Harry-Chen/fpga-virtual-console/doc/report/report.tex

 % !TEX root = report.tex
 % !TEX program = xelatex
 
\documentclass[fontset=fandol]{ctexart}

\usepackage{graphicx}
\usepackage{lscape}
\usepackage{geometry}
\usepackage{hyperref}
\usepackage{hyperxmp}
\usepackage{pdfpages}
\usepackage{longtable}
\usepackage{booktabs}
\usepackage[bottom]{footmisc}
\usepackage{amsmath}
\usepackage{bytefield}
\usepackage{url}

\newcommand{\artauthor}{陈晟祺；周聿浩}
\newcommand{\arttitle}{FPGA Console 设计报告}
\newcommand{\artsubject}{硬件实现的 VT220 兼容终端}
\newcommand{\artkeywords}{FPGA；终端；Console}

\hypersetup{pdfauthor=\artauthor,
			pdftitle=\arttitle,
			pdfsubject=\artsubject,
			pdfkeywords=\artkeywords,
			pdfcopyright={Copyright Shengqi Chen & Yuhao zhou 2018. All rights reserved.},
			pdfdate=\today,
			pdfdisplaydoctitle=true,
			pdflang=zh-CN,
			pdfstartview=FitH}

\geometry{
	a4paper,
	left=3.18cm,
	right=3.18cm,
	top=2.54cm,
	bottom=2.54cm
}
\graphicspath{{figures/}}

\begin{document}

\title{{\bf\arttitle\\——\artsubject}}
\author{
计63\hspace{1em}陈晟祺\hspace{1em}2016010981 \\
计64\hspace{1em}周聿浩\hspace{1em}2016011347
}
\date{}
\maketitle

\tableofcontents

\section{项目概述}

\input{introduction}

\section{架构设计}

\input{architecture}

% implementation
\input{implementation}

\section{其他说明}

\input{misc}

\end{document}
