Harry-Chen/fpga-virtual-console/doc/report/misc.tex

 % !TEX root = report.tex
 % !TEX program = xelatex

 本项目是基于Cyclone IV EP4CE55F23I7开发的，具体的运行说明请见源码根目录下的\texttt{README.md}。

 感谢计研173张宇翔学长提供的项目灵感和实验板，他在我们的开发过程中帮助我们解答了各类疑难问题，也协助我们进行了一些调试工作。
 同时也感谢老师和助教的大力支持。缺少了诸位的帮助，写好这个项目是不可能的。
