Harry-Chen/fpga-virtual-console/demo/demo-commands.md

# Setup

For VT220 mode, run `./set_vt220.sh`.

For Xterm mode, run `./set_xterm.sh`.

# VT220 Mode

* `aafire`
* `aatest`
* `bb`
* `cowsay`
* `./bad_apple.sh`

# XTerm Mode

* `cacafire`
* `cacademo`
* `cacaview [images_path]`
* `screenfetch`
* `./asciicam.sh`
* `./video.sh [video_path]`
* `./emacs`, then input `ESC-x` and `tetris`.
* `cmatrix`
* `toilet`
* `ninvaders`: Ncurses based space invaders clone.
* `nsnake `: Customizable Snake game with ncurses for the terminal.
