Harry-Chen/fpga-virtual-console/doc/reference/websites.md

[Hardware implementation of an EAN-13 bar... (PDF Download Available)](https://www.researchgate.net/publication/4012338_Hardware_implementation_of_an_EAN-13_bar_code_decoder)

[Add a real life hardware terminal to that newfangled computer of yours | Hackaday](https://hackaday.com/2011/08/11/add-a-real-life-hardware-terminal-to-that-newfangled-computer-of-yours/)

[vt100 terminal emulator in a FPGA - how small can the FPGA be? - Google 网上论坛](https://groups.google.com/forum/#!topic/comp.terminals/9ydsHcoIR7k)

[FPGA Serial Terminal | Hackaday.io](https://hackaday.io/project/7165-fpga-serial-terminal)

[Video Terminals](http://www.sparetimegizmos.com/Hardware/VT.htm)

[Video Terminal Project](http://vt4.sourceforge.net/)

[vt100 | Hackaday](https://hackaday.com/tag/vt100/)

[howardjones/fpga-vt: VT100-style terminal implemented on FPGA in VHDL](https://github.com/howardjones/fpga-vt)

[bash:tip_colors_and_formatting - FLOZz' MISC](https://misc.flogisoft.com/bash/tip_colors_and_formatting)

[Video Display Terminal Information – VT100.net](https://vt100.net/)

[NCURSES — Frequently Asked Questions (FAQ)](http://invisible-island.net/ncurses/ncurses.faq.html#vt100_color)

[keyboard fpga combination - Google 搜索](https://www.google.com/search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)

[PS/2 Keyboard to ASCII Converter (VHDL) - Logic - eewiki](https://eewiki.net/pages/viewpage.action?pageId=28279002)

[FPGA Keyboard Interface – Embedded Thoughts](https://embeddedthoughts.com/2016/07/05/fpga-keyboard-interface/)

[PS2 Keyboard for FPGA](http://www.instructables.com/id/PS2-Keyboard-for-FPGA/)

[【小梅哥FPGA进阶教程】第六章 PS2键盘驱动设计与验证 - FPGA/CPLD - 电子工程世界-论坛](http://bbs.eeworld.com.cn/thread-513009-1-1.html)

[Digital VT100 User Guide: Programmer Information](https://vt100.net/docs/vt100-ug/chapter3.html)

[PS2-KeyBoard-FPGA/ps2-keyboard-16.png at master · Obijuan/PS2-KeyBoard-FPGA](https://github.com/Obijuan/PS2-KeyBoard-FPGA/blob/master/wiki/ps2-keyboard-16.png)

[PS/2 Keyboard Interface (VHDL) - Logic - eewiki](https://eewiki.net/pages/viewpage.action?pageId=28278929)

[~libvterm/libvterm/trunk : files for revision 718](https://bazaar.launchpad.net/~libvterm/libvterm/trunk/files/head:/src/)

[VT100 commands](http://braun-home.net/michael/info/misc/VT100_commands.htm)

[The TTY demystified](http://www.linusakesson.net/programming/tty/index.php)

[Console Virtual Terminal Sequences](https://docs.microsoft.com/en-us/windows/console/console-virtual-terminal-sequences)
