Harry-Chen/fpga-virtual-console/(list of files, cad)

Other CAD files:
src/debug/stp.stp
