Harry-Chen/fpga-virtual-console/doc/report/figures/command_parser.pdf

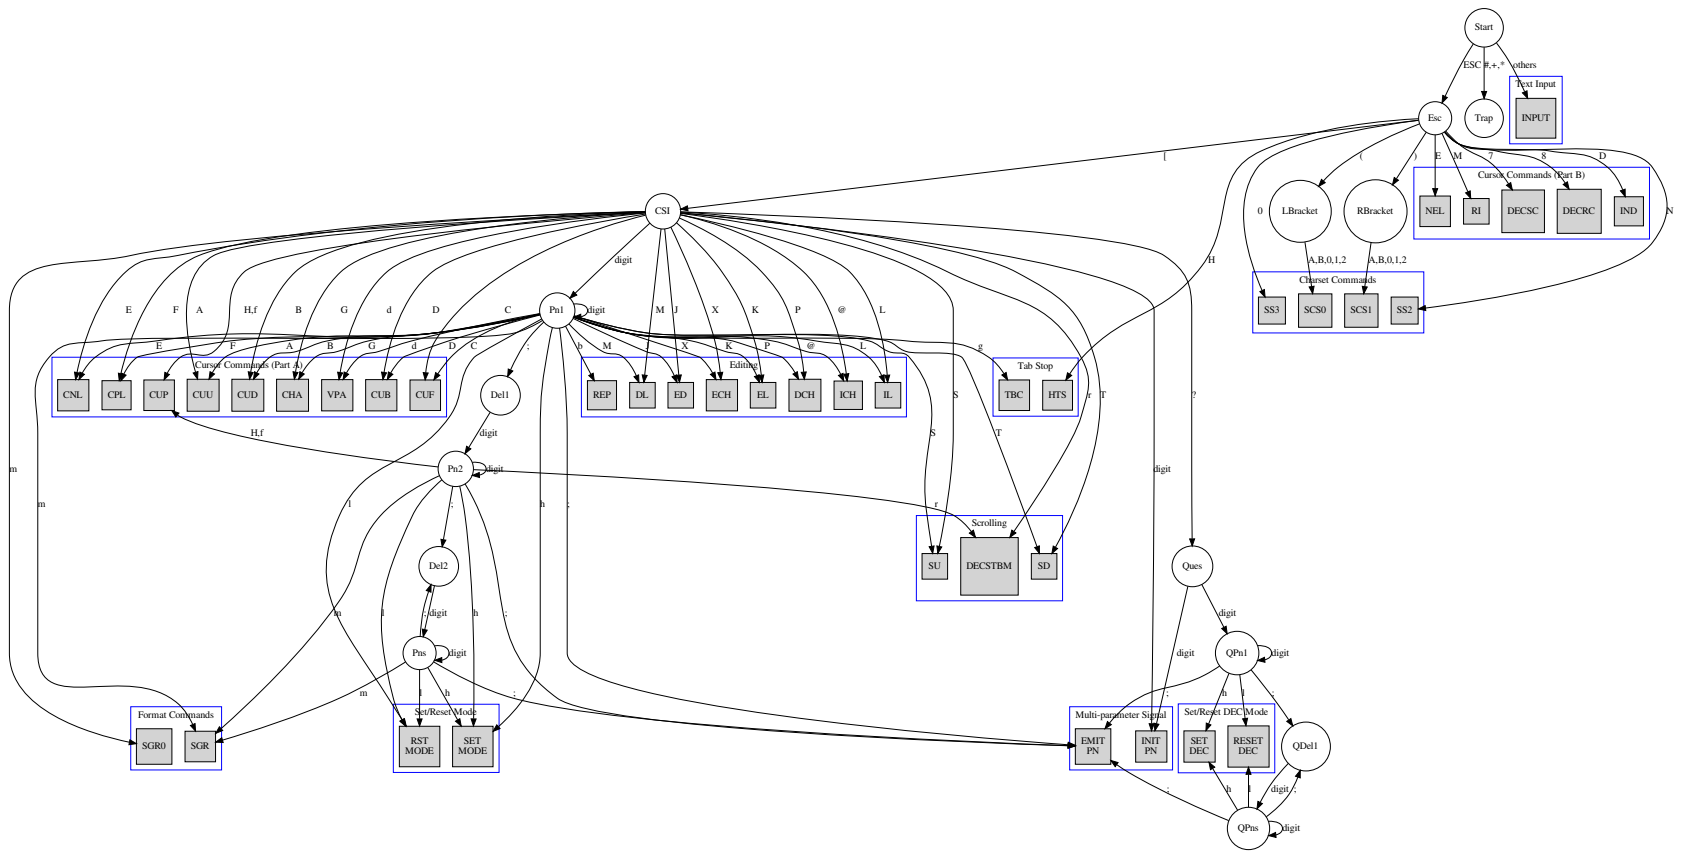
[picture p17: page 1]
Format Commands; Multi-parameter Signal; Charset Commands; Scrolling; Editing; Set/Reset Mode; Set/Reset DEC Mode; Text Input; Tab Stop; Start; Esc; ESC; Trap; INPUT; others; CSI; LBracket; RBracket; IND; NEL; DECSC; DECRC; HTS; digit; Ques; INIT PN; SGR0; CUU; CUD; CUF; CUB; CUP; CNL; CPL; CHA; VPA; DECSTBM; ECH; DCH; ICH; Del1; EMIT PN; SGR; REP; SET MODE; RST MODE; TBC; Del2; Pns; ; digit; SCS0; SCS1; QPn1; QDel1; SET DEC; RESET DEC; QPns; digit ;

Cursor Commands (Part B)

Cursor Commands (Part A)
