Harry-Chen/fpga-virtual-console/doc/report/figures/architecture_design_visio.pdf

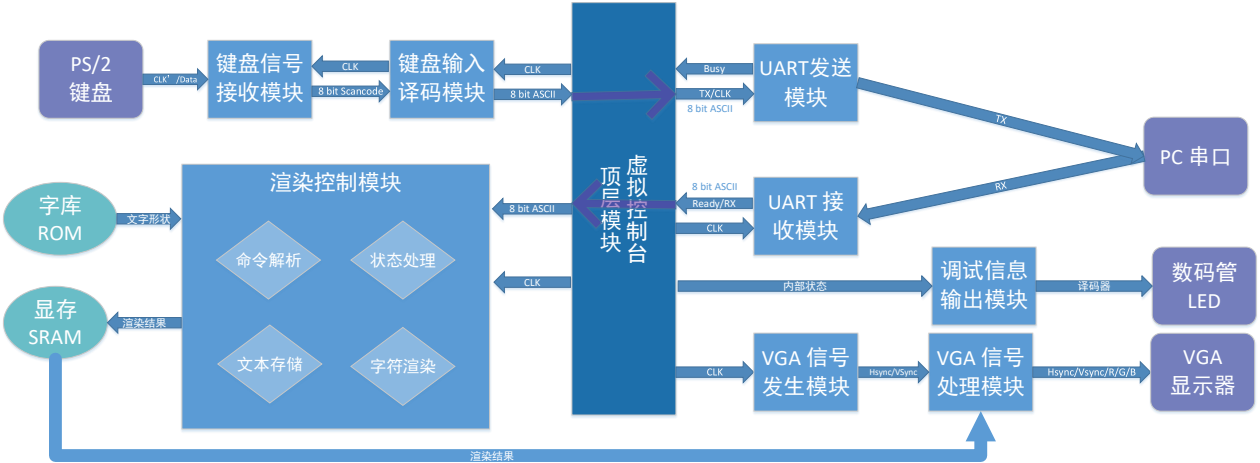
[picture p18: page 1]
键盘信号 接收模块; 键盘输入 译码模块; 虚拟控制台; 顶层模块; UART发送 模块; UART; 接 收模块; VGA 信号 处理模块; Busy; Ready; VGA 显示器; CLK CLK; Hsync; /VSync; VGA 信号 发生模块; 渲染控制模块; 8 bit ASCII; CLK; 字库 ROM; 文字形状; 显存 SRAM; 渲染结果; 命令解析; 状态处理; 文本存储; 字符渲染; 调试信息 输出模块; 数码管 LED; 内部状态; 译码器
