Harry-Chen/fpga-virtual-console/doc/report/figures/graphics_control.pdf

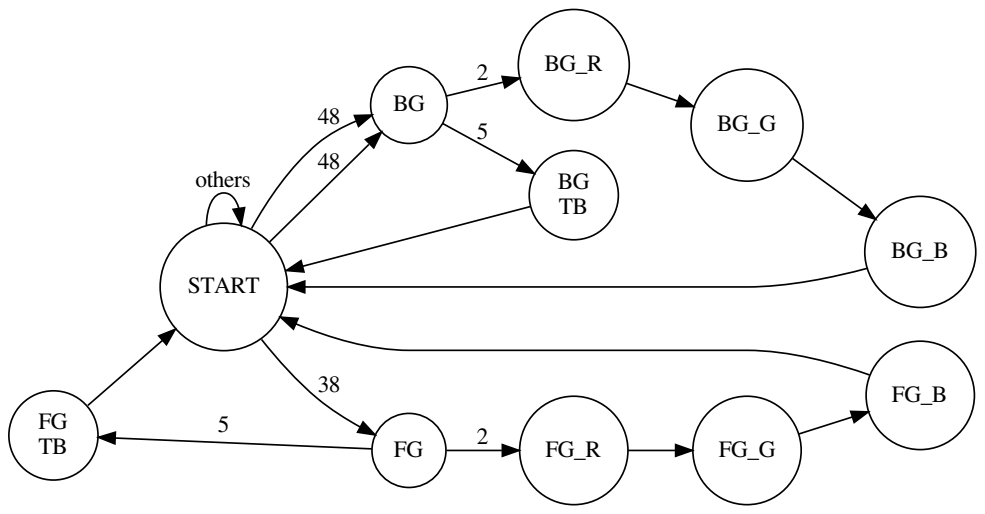
[picture p19: page 1]
START; others
