Harry-Chen/fpga-virtual-console/doc/report/figures/text_control.pdf

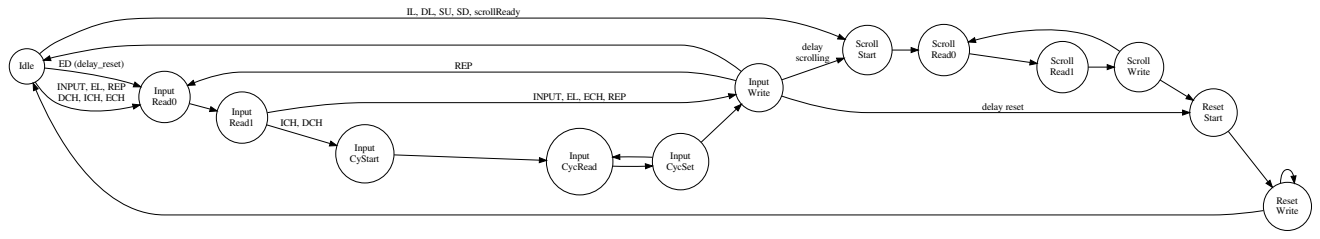
[picture p20: page 1]
Idle; Input Read0; ED (delay_reset); Scroll Start; Input Read1; Input CyStart; ICH, DCH; Input; Input CycRead; Input CycSet; REP; delay scrolling; Reset Start; delay reset; Scroll; Read0; Read1; Scroll Write; Reset Write

IL, DL, SU, SD, scrollReady

INPUT, EL, REP
DCH, ICH, ECH

Write INPUT, EL, ECH, REP
