Harry-Chen/fpga-virtual-console/testbench/TextRam.v

// synopsys translate_off
`timescale 1 ps / 1 ps
// synopsys translate_on
module TextRam (
	aclr_a,
	aclr_b,
	address_a,
	address_b,
	clock_a,
	clock_b,
	data_a,
	data_b,
	wren_a,
	wren_b,
	q_a,
	q_b);

	input	  aclr_a;
	input	  aclr_b;
	input	[5:0]  address_a;
	input	[5:0]  address_b;
	input	  clock_a;
	input	  clock_b;
	input	[1279:0]  data_a;
	input	[1279:0]  data_b;
	input	  wren_a;
	input	  wren_b;
	output	[1279:0]  q_a;
	output	[1279:0]  q_b;
`ifndef ALTERA_RESERVED_QIS
// synopsys translate_off
`endif
	tri0	  aclr_a;
	tri0	  aclr_b;
	tri1	  clock_a;
	tri0	  wren_a;
	tri0	  wren_b;
`ifndef ALTERA_RESERVED_QIS
// synopsys translate_on
`endif

	wire [1279:0] sub_wire0;
	wire [1279:0] sub_wire1;
	wire [1279:0] q_a = sub_wire0[1279:0];
	wire [1279:0] q_b = sub_wire1[1279:0];

	altsyncram	altsyncram_component (
				.aclr0 (aclr_a),
				.aclr1 (aclr_b),
				.address_a (address_a),
				.address_b (address_b),
				.clock0 (clock_a),
				.clock1 (clock_b),
				.data_a (data_a),
				.data_b (data_b),
				.wren_a (wren_a),
				.wren_b (wren_b),
				.q_a (sub_wire0),
				.q_b (sub_wire1),
				.addressstall_a (1'b0),
				.addressstall_b (1'b0),
				.byteena_a (1'b1),
				.byteena_b (1'b1),
				.clocken0 (1'b1),
				.clocken1 (1'b1),
				.clocken2 (1'b1),
				.clocken3 (1'b1),
				.eccstatus (),
				.rden_a (1'b1),
				.rden_b (1'b1));
	defparam
		altsyncram_component.address_reg_b = "CLOCK1",
		altsyncram_component.clock_enable_input_a = "BYPASS",
		altsyncram_component.clock_enable_input_b = "BYPASS",
		altsyncram_component.clock_enable_output_a = "BYPASS",
		altsyncram_component.clock_enable_output_b = "BYPASS",
		altsyncram_component.indata_reg_b = "CLOCK1",
		altsyncram_component.init_file = "TextRamDemo.hex",
		altsyncram_component.intended_device_family = "Cyclone IV E",
		altsyncram_component.lpm_type = "altsyncram",
		altsyncram_component.numwords_a = 40,
		altsyncram_component.numwords_b = 40,
		altsyncram_component.operation_mode = "BIDIR_DUAL_PORT",
		altsyncram_component.outdata_aclr_a = "CLEAR0",
		altsyncram_component.outdata_aclr_b = "CLEAR1",
		altsyncram_component.outdata_reg_a = "UNREGISTERED",
		altsyncram_component.outdata_reg_b = "UNREGISTERED",
		altsyncram_component.power_up_uninitialized = "FALSE",
		altsyncram_component.read_during_write_mode_port_a = "NEW_DATA_WITH_NBE_READ",
		altsyncram_component.read_during_write_mode_port_b = "NEW_DATA_WITH_NBE_READ",
		altsyncram_component.widthad_a = 6,
		altsyncram_component.widthad_b = 6,
		altsyncram_component.width_a = 1280,
		altsyncram_component.width_b = 1280,
		altsyncram_component.width_byteena_a = 1,
		altsyncram_component.width_byteena_b = 1,
		altsyncram_component.wrcontrol_wraddress_reg_b = "CLOCK1";


endmodule
