Harry-Chen/fpga-virtual-console/src/utility/DivideMod.sv

module DivideMod(
	input  [7:0] X,
	output [7:0] Q, R
);

parameter Mod = 2;

always_comb
begin
	case(X)
		8'h00: begin
			Q = 8'h00 / 8'(Mod);
			R = 8'h00 % 8'(Mod);
		end
		8'h01: begin
			Q = 8'h01 / 8'(Mod);
			R = 8'h01 % 8'(Mod);
		end
		8'h02: begin
			Q = 8'h02 / 8'(Mod);
			R = 8'h02 % 8'(Mod);
		end
		8'h03: begin
			Q = 8'h03 / 8'(Mod);
			R = 8'h03 % 8'(Mod);
		end
		8'h04: begin
			Q = 8'h04 / 8'(Mod);
			R = 8'h04 % 8'(Mod);
		end
		8'h05: begin
			Q = 8'h05 / 8'(Mod);
			R = 8'h05 % 8'(Mod);
		end
		8'h06: begin
			Q = 8'h06 / 8'(Mod);
			R = 8'h06 % 8'(Mod);
		end
		8'h07: begin
			Q = 8'h07 / 8'(Mod);
			R = 8'h07 % 8'(Mod);
		end
		8'h08: begin
			Q = 8'h08 / 8'(Mod);
			R = 8'h08 % 8'(Mod);
		end
		8'h09: begin
			Q = 8'h09 / 8'(Mod);
			R = 8'h09 % 8'(Mod);
		end
		8'h0a: begin
			Q = 8'h0a / 8'(Mod);
			R = 8'h0a % 8'(Mod);
		end
		8'h0b: begin
			Q = 8'h0b / 8'(Mod);
			R = 8'h0b % 8'(Mod);
		end
		8'h0c: begin
			Q = 8'h0c / 8'(Mod);
			R = 8'h0c % 8'(Mod);
		end
		8'h0d: begin
			Q = 8'h0d / 8'(Mod);
			R = 8'h0d % 8'(Mod);
		end
		8'h0e: begin
			Q = 8'h0e / 8'(Mod);
			R = 8'h0e % 8'(Mod);
		end
		8'h0f: begin
			Q = 8'h0f / 8'(Mod);
			R = 8'h0f % 8'(Mod);
		end
		8'h10: begin
			Q = 8'h10 / 8'(Mod);
			R = 8'h10 % 8'(Mod);
		end
		8'h11: begin
			Q = 8'h11 / 8'(Mod);
			R = 8'h11 % 8'(Mod);
		end
		8'h12: begin
			Q = 8'h12 / 8'(Mod);
			R = 8'h12 % 8'(Mod);
		end
		8'h13: begin
			Q = 8'h13 / 8'(Mod);
			R = 8'h13 % 8'(Mod);
		end
		8'h14: begin
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
		end
		8'ha8: begin
			Q = 8'ha8 / 8'(Mod);
			R = 8'ha8 % 8'(Mod);
		end
		8'ha9: begin
			Q = 8'ha9 / 8'(Mod);
			R = 8'ha9 % 8'(Mod);
		end
		8'haa: begin
			Q = 8'haa / 8'(Mod);
			R = 8'haa % 8'(Mod);
		end
		8'hab: begin
			Q = 8'hab / 8'(Mod);
			R = 8'hab % 8'(Mod);
		end
		8'hac: begin
			Q = 8'hac / 8'(Mod);
			R = 8'hac % 8'(Mod);
		end
		8'had: begin
			Q = 8'had / 8'(Mod);
			R = 8'had % 8'(Mod);
		end
		8'hae: begin
			Q = 8'hae / 8'(Mod);
			R = 8'hae % 8'(Mod);
		end
		8'haf: begin
			Q = 8'haf / 8'(Mod);
			R = 8'haf % 8'(Mod);
		end
		8'hb0: begin
			Q = 8'hb0 / 8'(Mod);
			R = 8'hb0 % 8'(Mod);
		end
		8'hb1: begin
			Q = 8'hb1 / 8'(Mod);
			R = 8'hb1 % 8'(Mod);
		end
		8'hb2: begin
			Q = 8'hb2 / 8'(Mod);
			R = 8'hb2 % 8'(Mod);
		end
		8'hb3: begin
			Q = 8'hb3 / 8'(Mod);
			R = 8'hb3 % 8'(Mod);
		end
		8'hb4: begin
			Q = 8'hb4 / 8'(Mod);
			R = 8'hb4 % 8'(Mod);
		end
		8'hb5: begin
			Q = 8'hb5 / 8'(Mod);
			R = 8'hb5 % 8'(Mod);
		end
		8'hb6: begin
			Q = 8'hb6 / 8'(Mod);
			R = 8'hb6 % 8'(Mod);
		end
		8'hb7: begin
			Q = 8'hb7 / 8'(Mod);
			R = 8'hb7 % 8'(Mod);
		end
		8'hb8: begin
			Q = 8'hb8 / 8'(Mod);
			R = 8'hb8 % 8'(Mod);
		end
		8'hb9: begin
			Q = 8'hb9 / 8'(Mod);
			R = 8'hb9 % 8'(Mod);
		end
		8'hba: begin
			Q = 8'hba / 8'(Mod);
			R = 8'hba % 8'(Mod);
		end
		8'hbb: begin
			Q = 8'hbb / 8'(Mod);
			R = 8'hbb % 8'(Mod);
		end
		8'hbc: begin
			Q = 8'hbc / 8'(Mod);
			R = 8'hbc % 8'(Mod);
		end
		8'hbd: begin
			Q = 8'hbd / 8'(Mod);
			R = 8'hbd % 8'(Mod);
		end
		8'hbe: begin
			Q = 8'hbe / 8'(Mod);
			R = 8'hbe % 8'(Mod);
		end
		8'hbf: begin
			Q = 8'hbf / 8'(Mod);
			R = 8'hbf % 8'(Mod);
		end
		8'hc0: begin
			Q = 8'hc0 / 8'(Mod);
			R = 8'hc0 % 8'(Mod);
		end
		8'hc1: begin
			Q = 8'hc1 / 8'(Mod);
			R = 8'hc1 % 8'(Mod);
		end
		8'hc2: begin
			Q = 8'hc2 / 8'(Mod);
			R = 8'hc2 % 8'(Mod);
		end
		8'hc3: begin
			Q = 8'hc3 / 8'(Mod);
			R = 8'hc3 % 8'(Mod);
		end
		8'hc4: begin
			Q = 8'hc4 / 8'(Mod);
			R = 8'hc4 % 8'(Mod);
		end
		8'hc5: begin
			Q = 8'hc5 / 8'(Mod);
			R = 8'hc5 % 8'(Mod);
		end
		8'hc6: begin
			Q = 8'hc6 / 8'(Mod);
			R = 8'hc6 % 8'(Mod);
		end
		8'hc7: begin
			Q = 8'hc7 / 8'(Mod);
			R = 8'hc7 % 8'(Mod);
		end
		8'hc8: begin
			Q = 8'hc8 / 8'(Mod);
			R = 8'hc8 % 8'(Mod);
		end
		8'hc9: begin
			Q = 8'hc9 / 8'(Mod);
			R = 8'hc9 % 8'(Mod);
		end
		8'hca: begin
			Q = 8'hca / 8'(Mod);
			R = 8'hca % 8'(Mod);
		end
		8'hcb: begin
			Q = 8'hcb / 8'(Mod);
			R = 8'hcb % 8'(Mod);
		end
		8'hcc: begin
			Q = 8'hcc / 8'(Mod);
			R = 8'hcc % 8'(Mod);
		end
		8'hcd: begin
			Q = 8'hcd / 8'(Mod);
			R = 8'hcd % 8'(Mod);
		end
		8'hce: begin
			Q = 8'hce / 8'(Mod);
			R = 8'hce % 8'(Mod);
		end
		8'hcf: begin
			Q = 8'hcf / 8'(Mod);
			R = 8'hcf % 8'(Mod);
		end
		8'hd0: begin
			Q = 8'hd0 / 8'(Mod);
			R = 8'hd0 % 8'(Mod);
		end
		8'hd1: begin
			Q = 8'hd1 / 8'(Mod);
			R = 8'hd1 % 8'(Mod);
		end
		8'hd2: begin
			Q = 8'hd2 / 8'(Mod);
			R = 8'hd2 % 8'(Mod);
		end
		8'hd3: begin
			Q = 8'hd3 / 8'(Mod);
			R = 8'hd3 % 8'(Mod);
		end
		8'hd4: begin
			Q = 8'hd4 / 8'(Mod);
			R = 8'hd4 % 8'(Mod);
		end
		8'hd5: begin
			Q = 8'hd5 / 8'(Mod);
			R = 8'hd5 % 8'(Mod);
		end
		8'hd6: begin
			Q = 8'hd6 / 8'(Mod);
			R = 8'hd6 % 8'(Mod);
		end
		8'hd7: begin
			Q = 8'hd7 / 8'(Mod);
			R = 8'hd7 % 8'(Mod);
		end
		8'hd8: begin
			Q = 8'hd8 / 8'(Mod);
			R = 8'hd8 % 8'(Mod);
		end
		8'hd9: begin
			Q = 8'hd9 / 8'(Mod);
			R = 8'hd9 % 8'(Mod);
		end
		8'hda: begin
			Q = 8'hda / 8'(Mod);
			R = 8'hda % 8'(Mod);
		end
		8'hdb: begin
			Q = 8'hdb / 8'(Mod);
			R = 8'hdb % 8'(Mod);
		end
		8'hdc: begin
			Q = 8'hdc / 8'(Mod);
			R = 8'hdc % 8'(Mod);
		end
		8'hdd: begin
			Q = 8'hdd / 8'(Mod);
			R = 8'hdd % 8'(Mod);
		end
		8'hde: begin
			Q = 8'hde / 8'(Mod);
			R = 8'hde % 8'(Mod);
		end
		8'hdf: begin
			Q = 8'hdf / 8'(Mod);
			R = 8'hdf % 8'(Mod);
		end
		8'he0: begin
			Q = 8'he0 / 8'(Mod);
			R = 8'he0 % 8'(Mod);
		end
		8'he1: begin
			Q = 8'he1 / 8'(Mod);
			R = 8'he1 % 8'(Mod);
		end
		8'he2: begin
			Q = 8'he2 / 8'(Mod);
			R = 8'he2 % 8'(Mod);
		end
		8'he3: begin
			Q = 8'he3 / 8'(Mod);
			R = 8'he3 % 8'(Mod);
		end
		8'he4: begin
			Q = 8'he4 / 8'(Mod);
			R = 8'he4 % 8'(Mod);
		end
		8'he5: begin
			Q = 8'he5 / 8'(Mod);
			R = 8'he5 % 8'(Mod);
		end
		8'he6: begin
			Q = 8'he6 / 8'(Mod);
			R = 8'he6 % 8'(Mod);
		end
		8'he7: begin
			Q = 8'he7 / 8'(Mod);
			R = 8'he7 % 8'(Mod);
		end
		8'he8: begin
			Q = 8'he8 / 8'(Mod);
			R = 8'he8 % 8'(Mod);
		end
		8'he9: begin
			Q = 8'he9 / 8'(Mod);
			R = 8'he9 % 8'(Mod);
		end
		8'hea: begin
			Q = 8'hea / 8'(Mod);
			R = 8'hea % 8'(Mod);
		end
		8'heb: begin
			Q = 8'heb / 8'(Mod);
			R = 8'heb % 8'(Mod);
		end
		8'hec: begin
			Q = 8'hec / 8'(Mod);
			R = 8'hec % 8'(Mod);
		end
		8'hed: begin
			Q = 8'hed / 8'(Mod);
			R = 8'hed % 8'(Mod);
		end
		8'hee: begin
			Q = 8'hee / 8'(Mod);
			R = 8'hee % 8'(Mod);
		end
		8'hef: begin
			Q = 8'hef / 8'(Mod);
			R = 8'hef % 8'(Mod);
		end
		8'hf0: begin
			Q = 8'hf0 / 8'(Mod);
			R = 8'hf0 % 8'(Mod);
		end
		8'hf1: begin
			Q = 8'hf1 / 8'(Mod);
			R = 8'hf1 % 8'(Mod);
		end
		8'hf2: begin
			Q = 8'hf2 / 8'(Mod);
			R = 8'hf2 % 8'(Mod);
		end
		8'hf3: begin
			Q = 8'hf3 / 8'(Mod);
			R = 8'hf3 % 8'(Mod);
		end
		8'hf4: begin
			Q = 8'hf4 / 8'(Mod);
			R = 8'hf4 % 8'(Mod);
		end
		8'hf5: begin
			Q = 8'hf5 / 8'(Mod);
			R = 8'hf5 % 8'(Mod);
		end
		8'hf6: begin
			Q = 8'hf6 / 8'(Mod);
			R = 8'hf6 % 8'(Mod);
		end
		8'hf7: begin
			Q = 8'hf7 / 8'(Mod);
			R = 8'hf7 % 8'(Mod);
		end
		8'hf8: begin
			Q = 8'hf8 / 8'(Mod);
			R = 8'hf8 % 8'(Mod);
		end
		8'hf9: begin
			Q = 8'hf9 / 8'(Mod);
			R = 8'hf9 % 8'(Mod);
		end
		8'hfa: begin
			Q = 8'hfa / 8'(Mod);
			R = 8'hfa % 8'(Mod);
		end
		8'hfb: begin
			Q = 8'hfb / 8'(Mod);
			R = 8'hfb % 8'(Mod);
		end
		8'hfc: begin
			Q = 8'hfc / 8'(Mod);
			R = 8'hfc % 8'(Mod);
		end
		8'hfd: begin
			Q = 8'hfd / 8'(Mod);
			R = 8'hfd % 8'(Mod);
		end
		8'hfe: begin
			Q = 8'hfe / 8'(Mod);
			R = 8'hfe % 8'(Mod);
		end
		default: begin
			Q = 8'hff / 8'(Mod);
			R = 8'hff % 8'(Mod);
		end
	endcase
end

endmodule
