Harry-Chen/fpga-virtual-console/(commit log)

2018-05-03 Add uart module connection
2018-05-03 Add led and segmented display output
2018-05-08 Add Pin Planner files
2018-05-08 Fix VGA frequency error
    [VgaDisplayAdapter.v]
2018-05-15 Fix typo and add led bindings
2018-05-15 Use SystemVerilog and fix LED decoder
    [FpgaVirtualConsole.sv, LedDecoder.sv]
2018-05-15 Fix uart transciver
2018-05-17 Add SRAM bindings and data types
    [FpgaVirtualConsole.sv]
2018-05-17 Fix project file errors
    [FpgaVirtualConsole.sv]
2018-05-18 Fix state machine in SramController
    [SramController.sv]
2018-05-18 Add TextRenderer, but need fix
    [FontShapeRenderer.sv, FpgaVirtualConsole.sv, SramController.sv, TextRenderer.sv, VgaDisplayAdapter.sv]
2018-05-18 Switch to Cyclone IV
2018-05-18 Add debug probe
2018-05-18 Fix renderer, but calculating is not correct
    [FontShapeRenderer.sv, TextRenderer.sv]
2018-05-19 Fix coordinator calculating problem
    [FontShapeRenderer.sv, TextRenderer.sv]
2018-05-19 Fix too wide FontRom to save resources
    [SramController.sv]
2018-05-19 Reconstruct project structure
    [stp.stp]
2018-05-19 Rename header file and move Probe to debug folder
2018-05-22 Add coloring support II
    [stp.stp]
2018-05-22 Re-configure project
    [stp.stp]
2018-05-22 Trapped and ignored commands "ESC # <char>"
2018-05-24 Scrolling mode control. A worked version!
    [stp.stp]
2018-05-25 Fix timing problems in FontShapeRenderer
    [FontShapeRenderer.sv]
2018-05-25 Fix timing problems for vga controller
    [FontShapeRenderer.sv, TextRenderer.sv, VgaDisplayAdapter.sv]
2018-05-25 Fix timing problems for sram controller
    [SramController.sv]
2018-05-25 Revert "Fix timing problems for vga controller"
    This reverts commit 9ebf1217d9261776f937edc817f64e8298d5de20.
    [FontShapeRenderer.sv, TextRenderer.sv, VgaDisplayAdapter.sv]
2018-05-25 Revert "Fix timing problems in FontShapeRenderer"
    This reverts commit 1d61874e3d3276ec0e4e5ad689fc30497cc40dfe.
    [FontShapeRenderer.sv]
2018-05-25 Revert "Revert "Fix timing problems in FontShapeRenderer""
    This reverts commit c73bfc2d2311c6480fa99786271e6d1208e548d4.
    [FontShapeRenderer.sv]
2018-05-25 Revert "Revert "Fix timing problems for vga controller""
    This reverts commit 0af067674adcc58a460c9be975232fec29590204.
    [FontShapeRenderer.sv, TextRenderer.sv, VgaDisplayAdapter.sv]
2018-05-25 Revert "Fix timing problems for sram controller"
    This reverts commit 5150b506ac0a02484f70e40171e3ab142864de50.
    [SramController.sv]
2018-05-25 Graphics support.
    [stp.stp]
2018-05-26 Fix errors in FontShapeRenderer
    [FontShapeRenderer.sv]
2018-05-26 unique case -> case.
2018-05-26 Fix timing in TextControl.
    [TextControl.sv]
2018-05-26 Extract Display Controller and remove unused signals in SignalTap
    [stp.stp]
2018-05-30 Fix a small bug in Ps2Translator
    [Ps2Translator.sv]
2018-05-31 Trying to extend VGA resolution to 800*600, NOT WORKING!
    [DisplayController.sv, FontShapeRenderer.sv, SramController.sv, TextRam.v, TextRenderer.sv, VgaDisplayAdapter.sv]
2018-05-31 Fix VGA bug (value truncated)
    [DisplayController.sv, FpgaVirtualConsole.sv, VgaDisplayAdapter.sv]
2018-05-31 Fix warnings for truncated value
    [FontShapeRenderer.sv, TextRenderer.sv, VgaDisplayAdapter.sv]
2018-05-31 Fix bug: RST not connectedfor VideoController
    [FpgaVirtualConsole.sv, VideoController.sv]
2018-05-31 Fix bug: missing comma
    [FpgaVirtualConsole.sv]
2018-05-31 SU, SD, REP commands.
    [stp.stp]
2018-06-01 DCH fixed. (Bad_apple worked on VT220)
    [stp.stp]
2018-06-01 Printable characters.
2018-06-01 Colored camera worked.
2018-06-05 Fix Cursor blink on colored character
    [FontShapeRenderer.sv]
